a2zhelna/ESC/Images/ESCv1_bot.jpg

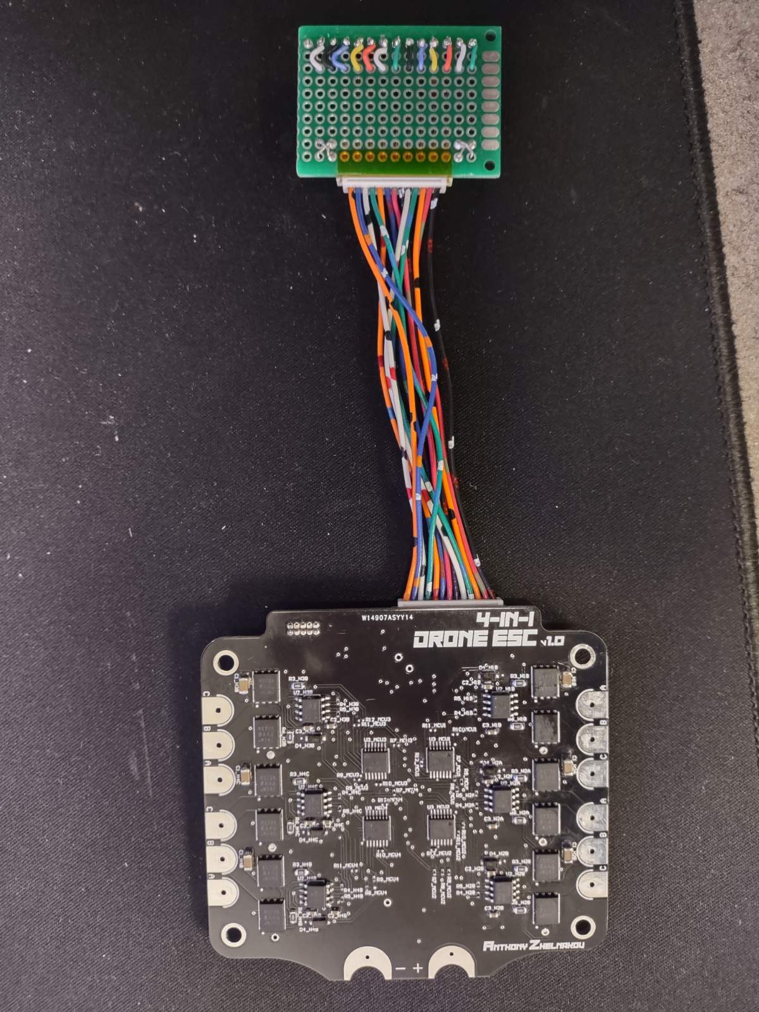
Images/ESCv1_bot.jpg
