a2zhelna/ESC/Images/ESCv1_top.jpg

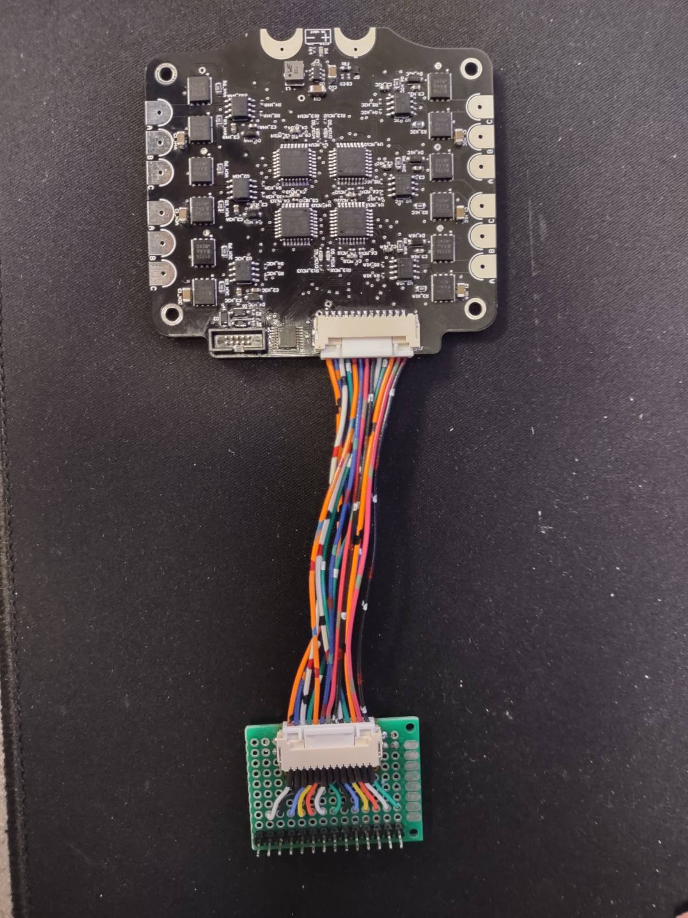
Images/ESCv1_top.jpg
