a2zhelna/ESC/Images/PCBBack.png

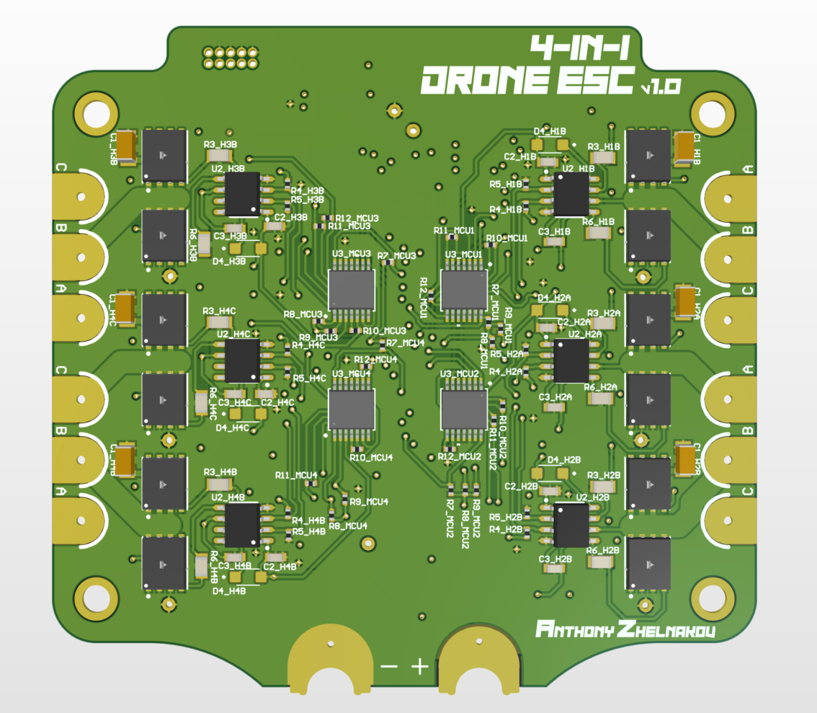
Images/PCBBack.png
