a2zhelna/ESC/Images/PCBFront.png

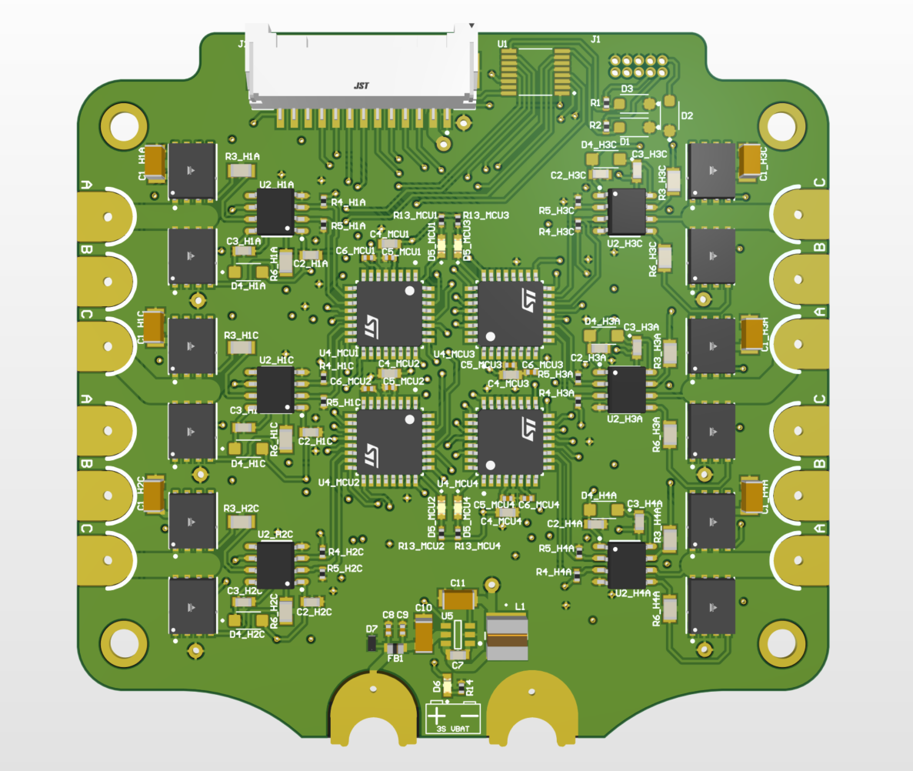
Images/PCBFront.png
