a2zhelna/ESC/(commit log)

2023-09-05 Added most of the ESC repository files
    - modified README
    - added STM32 code
    - added images
2023-09-22 added PCB images
2023-09-22 Add PCB images
